camdan-me/TeensyPixel/mfg_files/teensypixel_BOM.csv

No. | Quantity | Comment | Designator | Footprint | Value | Manufacturer Part | Manufacturer | Supplier Part | Supplier
1 | 1 | 1uF | C1 | C0603 | 1uF | CL10A105KB8NNNC | SAMSUNG(三星) | C15849 | LCSC
2 | 2 | MX126-5.0-02P-GN01-Cu-S-A | CN1A,CN1B | CONN-TH_2P-P5.00_MX126-5.0-GN01-02P-CU-S-A |  | MX126-5.0-02P-GN01-Cu-S-A | MAX(迈旭) | C5188434 | LCSC
3 | 24 | 100Ω | R1,R2,R3,R4,R5,R6,R7,R8,R9,R10,R11,R12,R13,R14,R15,R16,R17,R18,R19,R20,R21,R22,R23,R24 | R0402 | 100Ω | 0402WGF1000TCE | UNI-ROYAL(厚声) | C25076 | LCSC
4 | 3 | R-RJ45R10P-B000 | RJ1,RJ2,RJ3 | RJ45-TH_R-RJ45R10P-B000 |  | R-RJ45R10P-B000 | Ckmtw(灿科盟) | C386758 | LCSC
5 | 3 | SN74HCT245PWR | U1,U2,U3 | TSSOP-20_L6.5-W4.4-P0.65-LS6.4-BL |  | SN74HCT245PWR | TI(德州仪器) | C6779 | LCSC
