camdan-me/TeensyPixel/drawings/Teensy NeoPixel Baseboard_PCB.pdf

- +

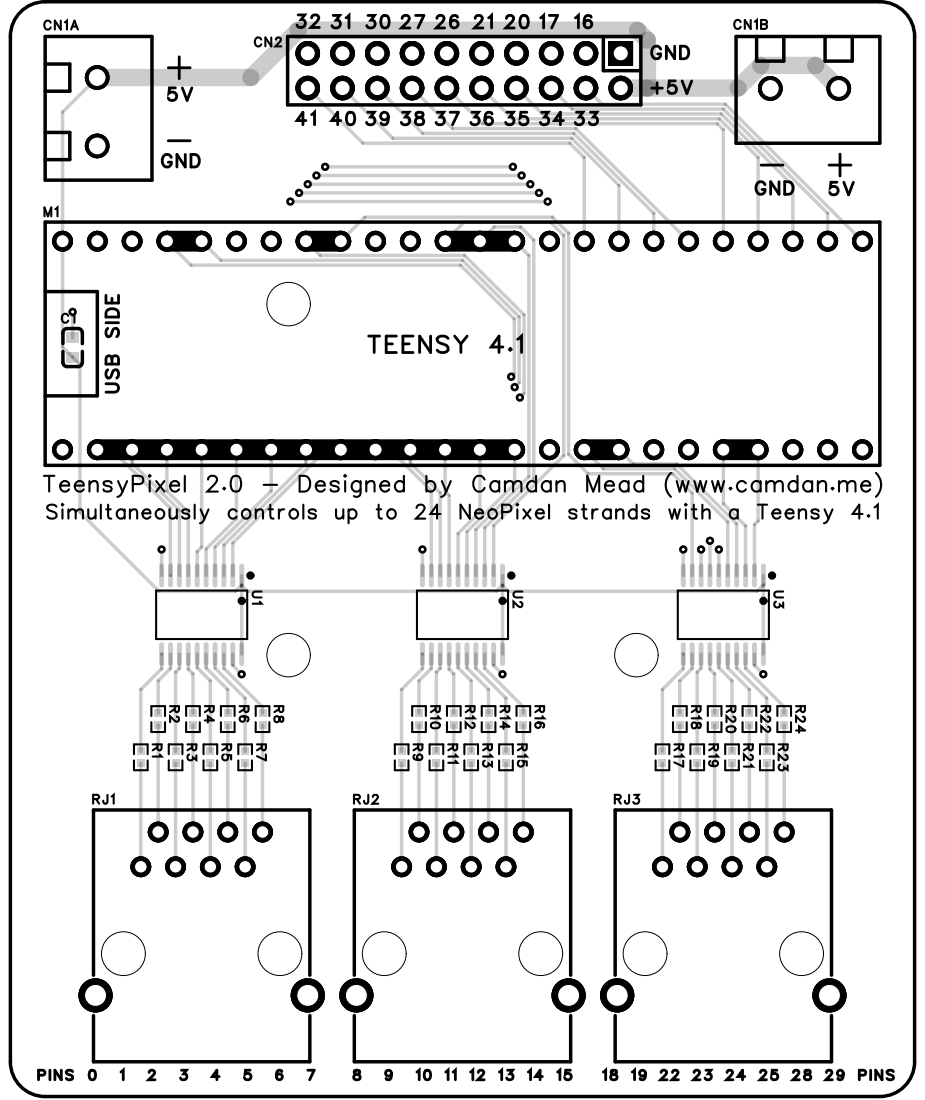
[picture p8: page 1]

TeensyPixel 2.0 - Designed by Camdan Mead (www.camdan.me)
Simultaneously controls up to 24 NeoPixel strands with a Teensy 4.1

+

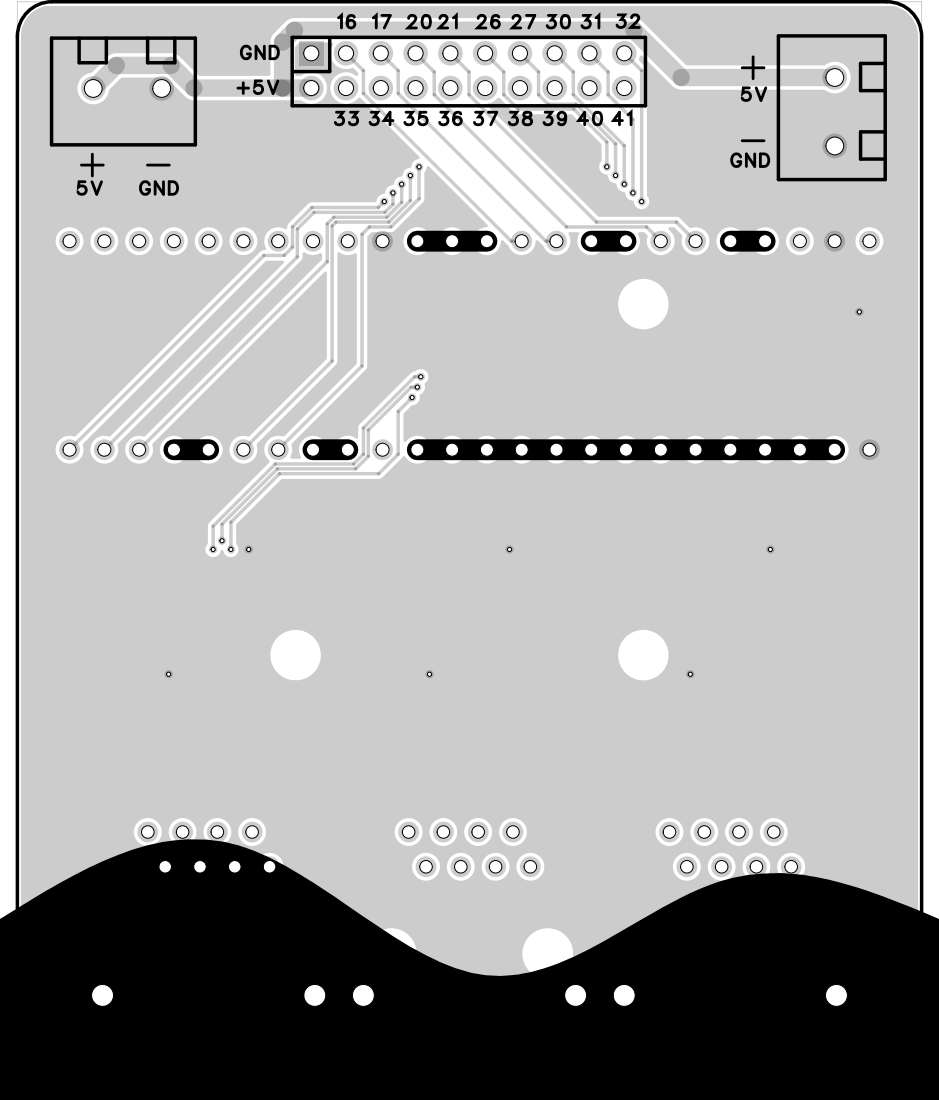
[picture p9: page 2]
