camdan-me/TeensyPixel/drawings/Teensy NeoPixel Baseboard_Schematic.pdf

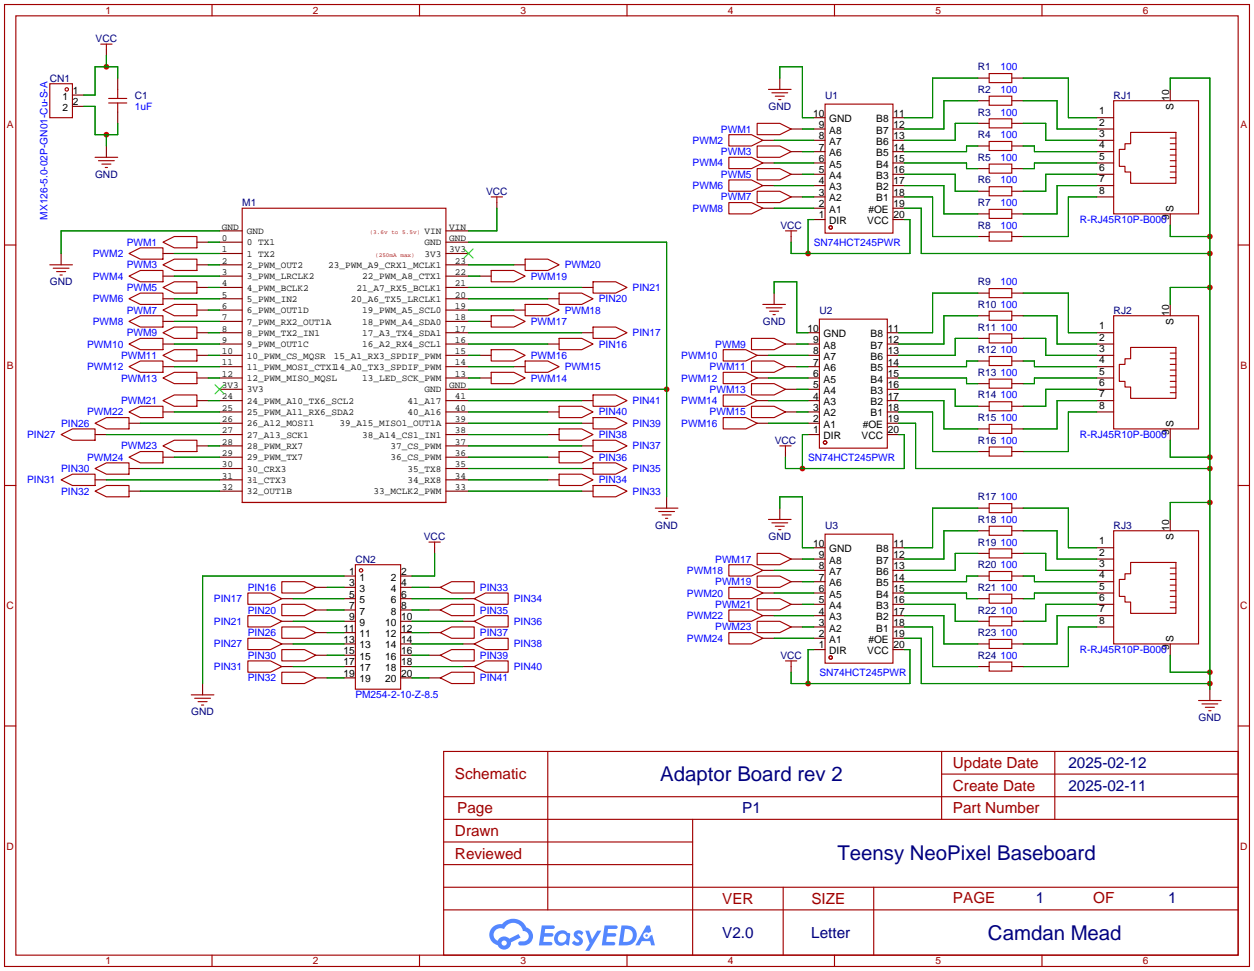
[picture p10: page 1]
