camdan-me/TeensyPixel/(list of files, drawings)

Other design files:
src_files/teensypixel.epro
