camdan-me/TeensyPixel/(commit log)

2025-02-17 Add source and manufacturing files
    [Teensy NeoPixel Baseboard_BOM.csv, Teensy NeoPixel Baseboard_EasyEDA Pro Project.epro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]
2025-02-17 Add instructions to README
    [teensypixel.epro, teensypixel_BOM.csv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]
